RaulBlancoGonzalez/ManoBionica/ESQ/Esquema diseño interruptor y circuito en Placa.png

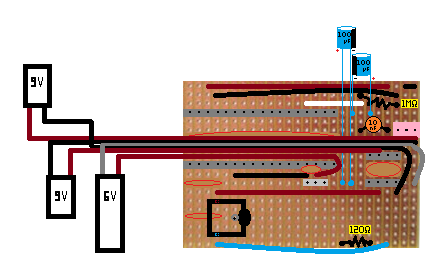
ESQ/Esquema diseño interruptor y circuito en Placa.png
