RaulBlancoGonzalez/ManoBionica/IMG/Robot50%.jpg

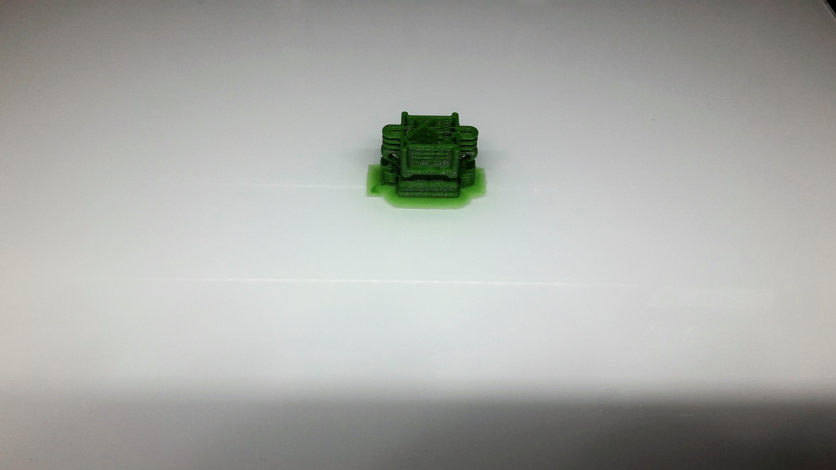
IMG/Robot50%.jpg
