RaulBlancoGonzalez/ManoBionica/ESQ/Arduino Micro.jpg

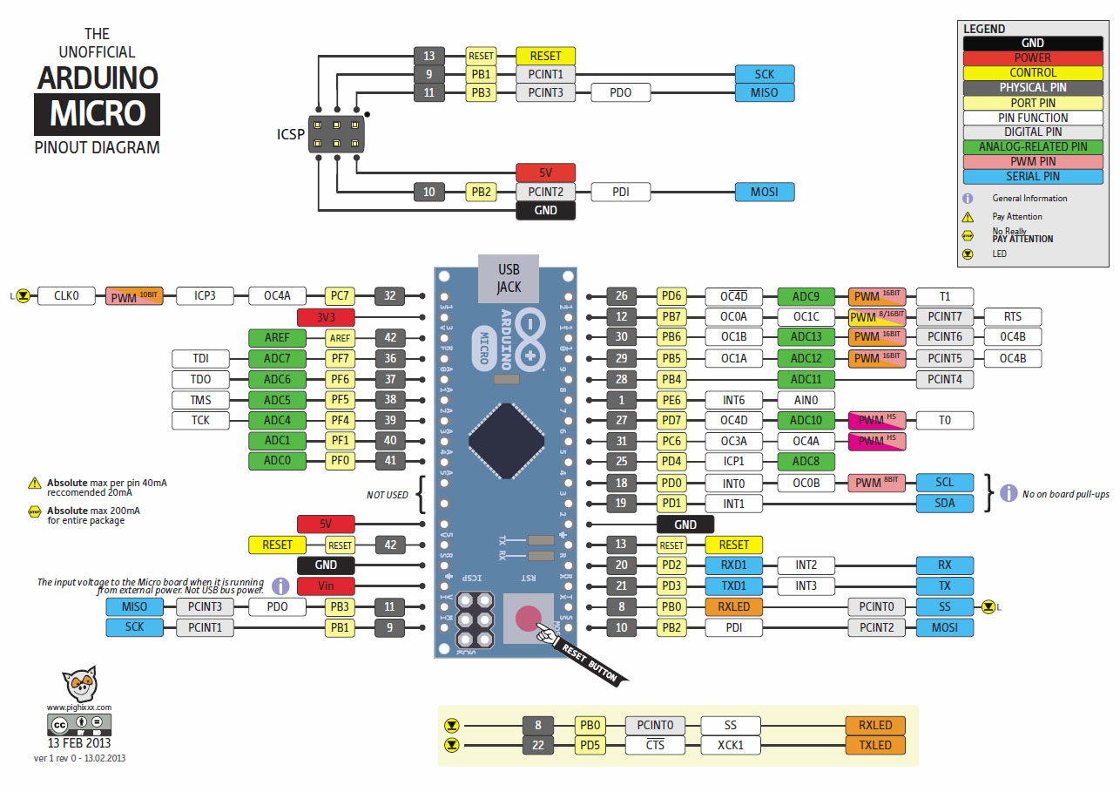
ESQ/Arduino Micro.jpg
