RaulBlancoGonzalez/ManoBionica/ESQ/ArduinoMicro_Pinout.png

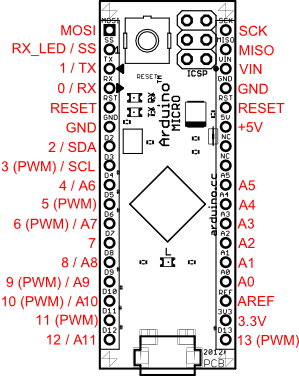
ESQ/ArduinoMicro_Pinout.png
