RaulBlancoGonzalez/ManoBionica/ESQ/Esquema Circuito Frontal.jpg

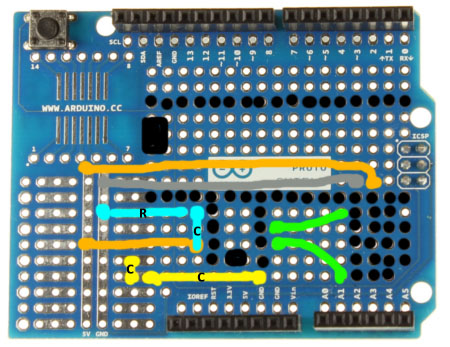
ESQ/Esquema Circuito Frontal.jpg
