RaulBlancoGonzalez/ManoBionica/ESQ/Esquema Circuito Trasero.jpg

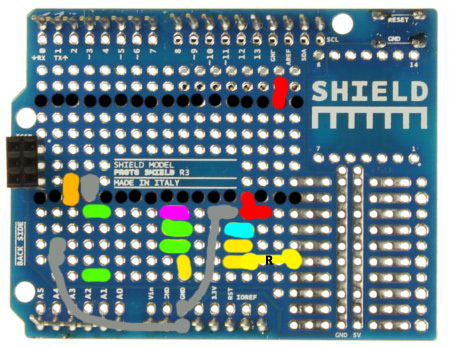
ESQ/Esquema Circuito Trasero.jpg
