RaulBlancoGonzalez/ManoBionica/IMG/Dedo1.jpg

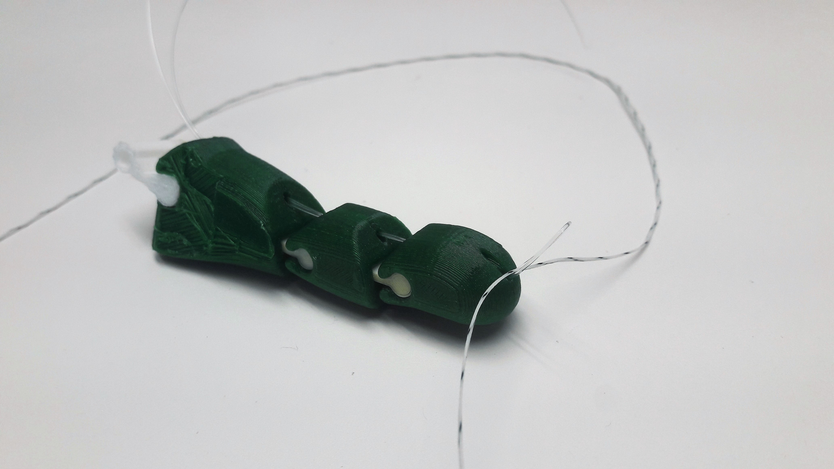
IMG/Dedo1.jpg
