RaulBlancoGonzalez/ManoBionica/IMG/Dedo3.jpg

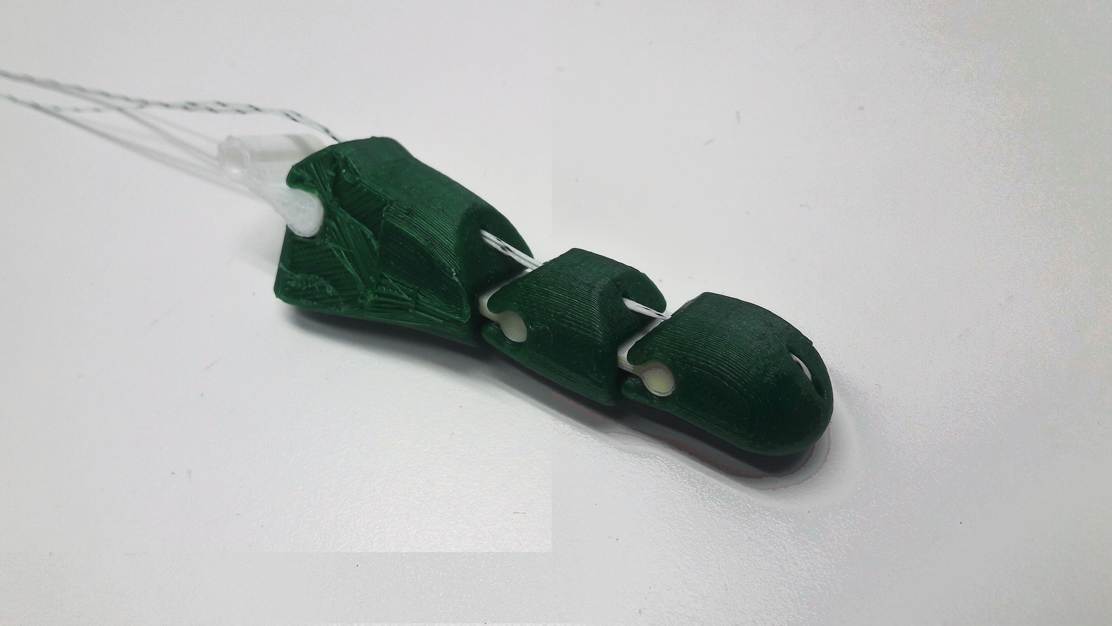
IMG/Dedo3.jpg
