RaulBlancoGonzalez/ManoBionica/IMG/ManoAbierta.jpg

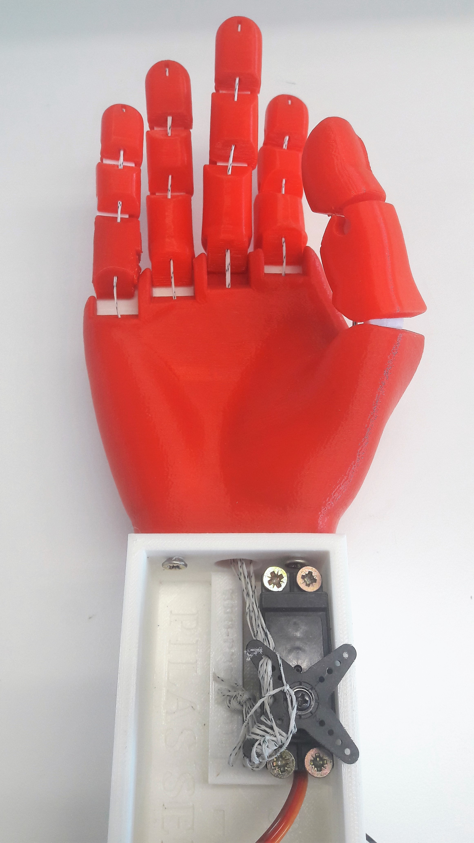
IMG/ManoAbierta.jpg
