RaulBlancoGonzalez/ManoBionica/IMG/Palmaydedos02.jpg

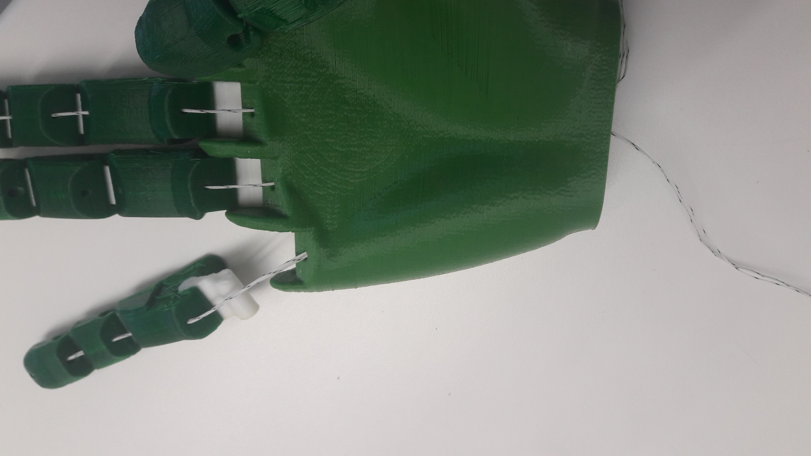
IMG/Palmaydedos02.jpg
