RaulBlancoGonzalez/ManoBionica/IMG/PlacaArduinoProtoShield.jpg

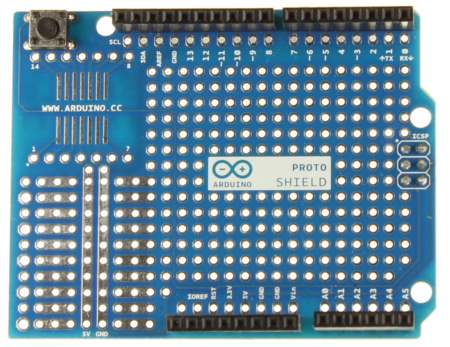
IMG/PlacaArduinoProtoShield.jpg
