RaulBlancoGonzalez/ManoBionica/IMG/PlacaBasePrototipado.jpg

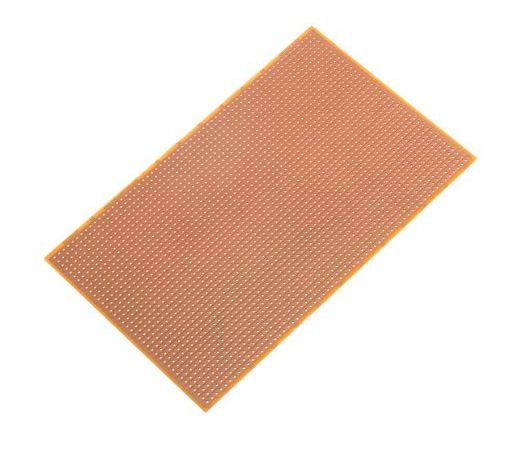
IMG/PlacaBasePrototipado.jpg
