RaulBlancoGonzalez/ManoBionica/IMG/Robot1%.jpg

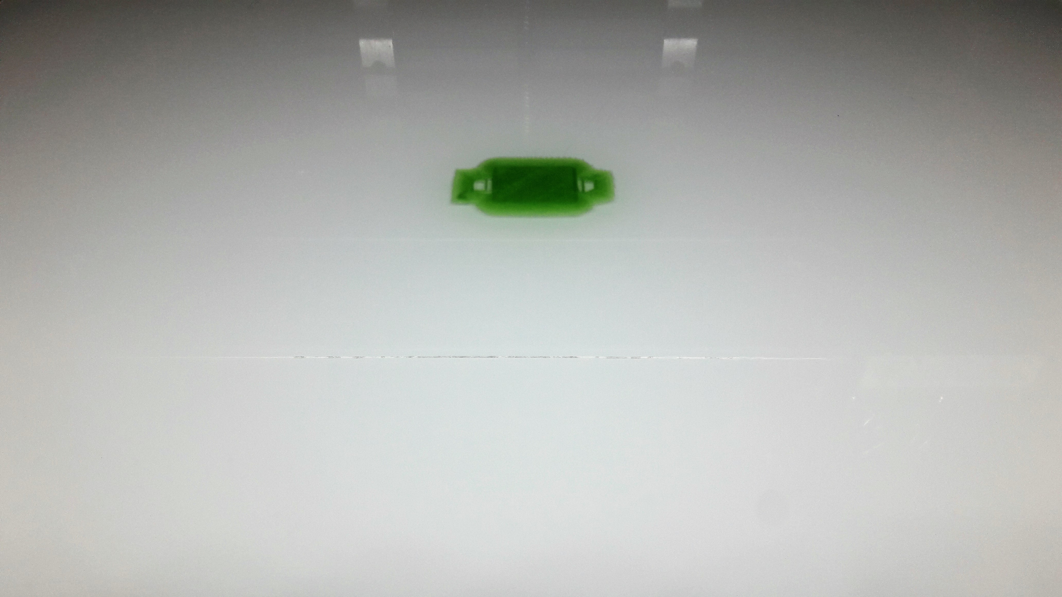
IMG/Robot1%.jpg
