RaulBlancoGonzalez/ManoBionica/IMG/Robot100%.jpg

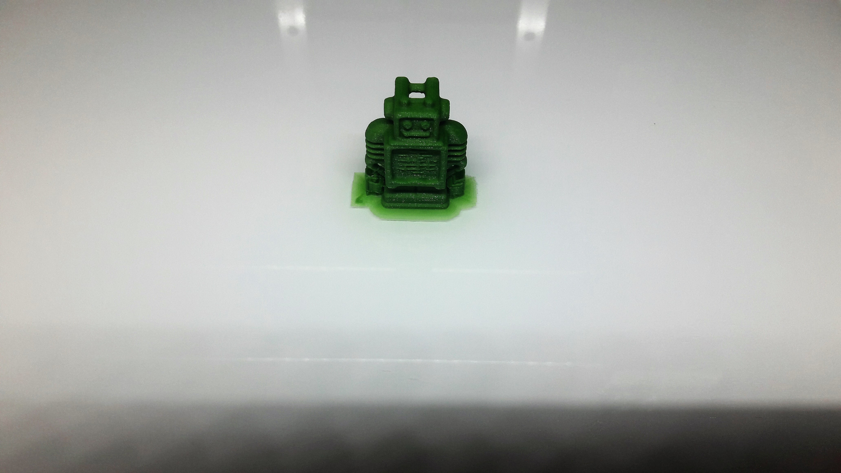
IMG/Robot100%.jpg
