RaulBlancoGonzalez/ManoBionica/IMG/Robot.jpg

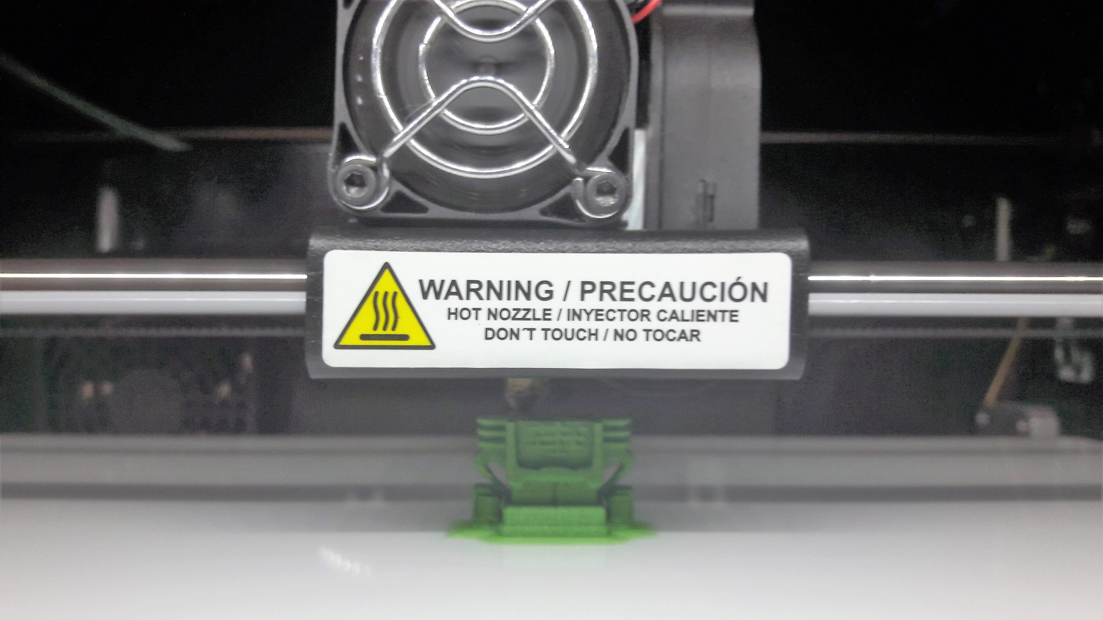
IMG/Robot.jpg
