RaulBlancoGonzalez/ManoBionica/IMG/SistemaCompleto.jpg

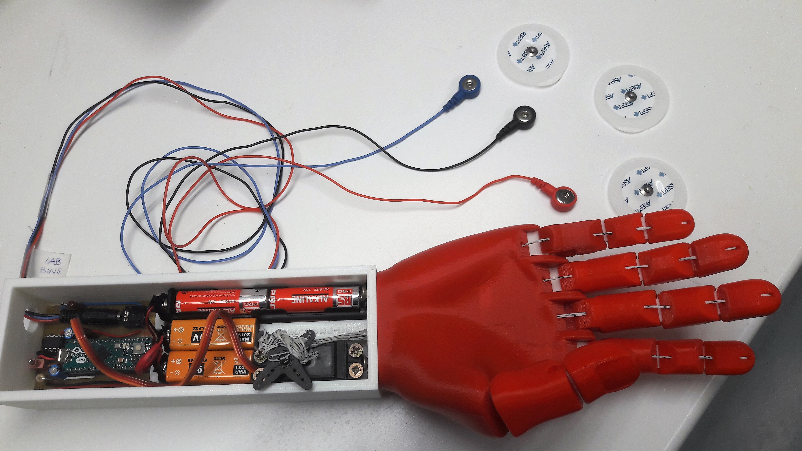
IMG/SistemaCompleto.jpg
