RaulBlancoGonzalez/ManoBionica/3D/STL/DedosIzquierda.stl

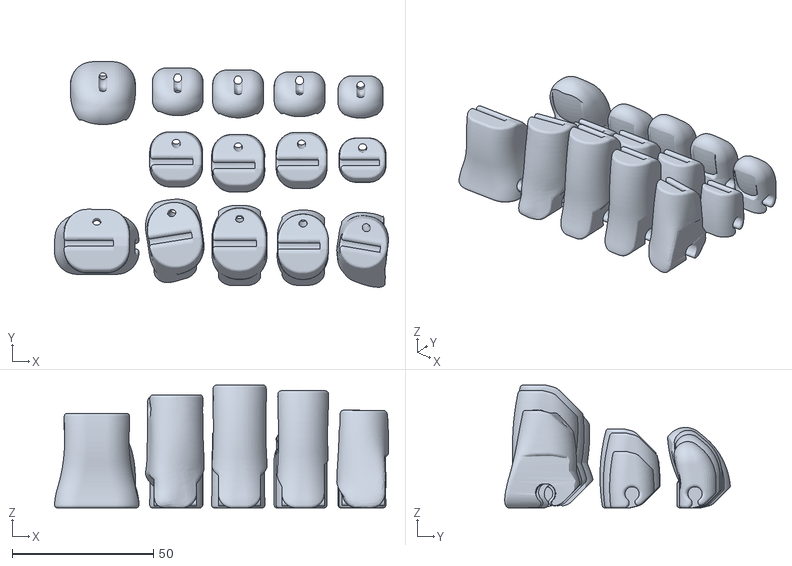
[picture p35: CAD file, 2018-05-22]
3D/STL/DedosIzquierda.stl
118.3 x 79.9 x 43.5
