RaulBlancoGonzalez/ManoBionica/3D/STL/ArticulacionPequeña.stl

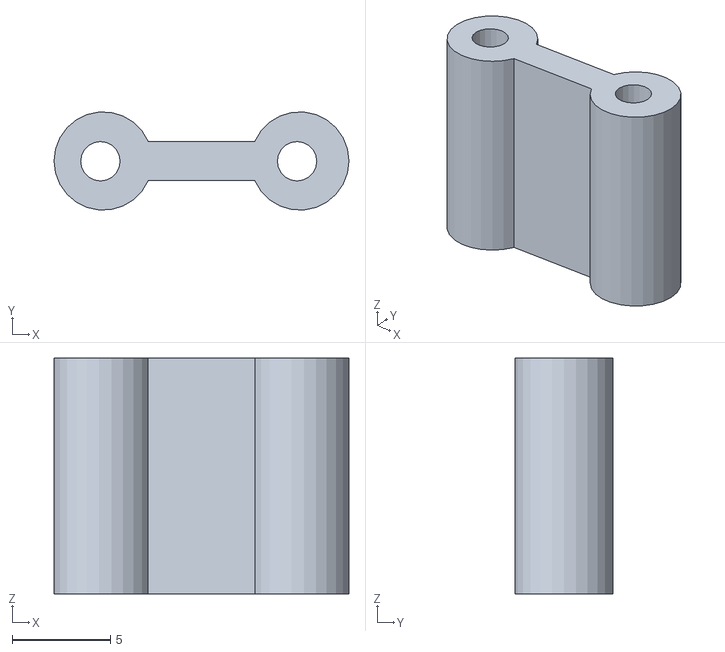
[picture p36: CAD file, 2018-05-22]
3D/STL/ArticulacionPequeña.stl
15.0 x 4.98 x 12.0
