RaulBlancoGonzalez/ManoBionica/3D/STL/Antebrazo.stl

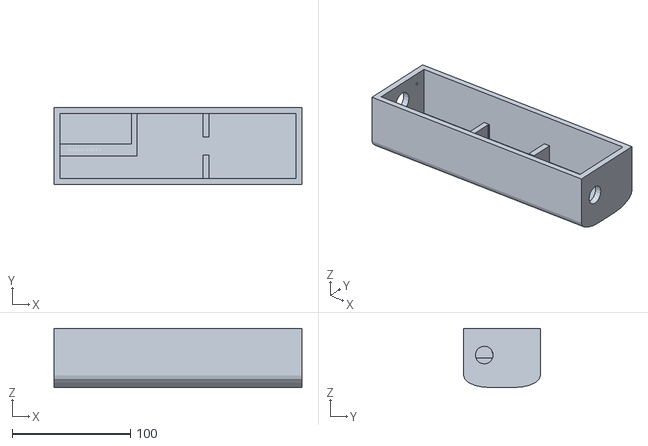
[picture p37: CAD file, 2018-05-22]
3D/STL/Antebrazo.stl
210.0 x 65.0 x 50.0
