RaulBlancoGonzalez/ManoBionica/3D/STL/PalmaDerecha.stl

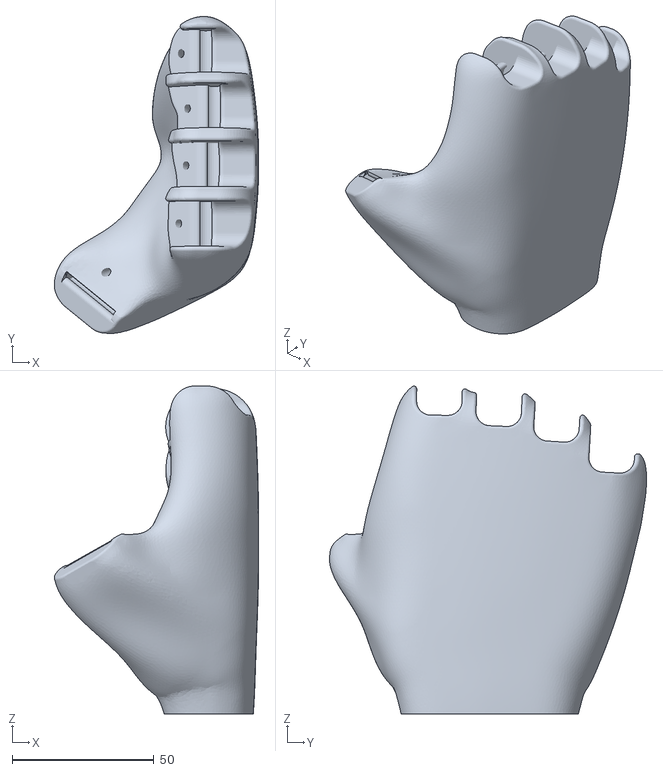
[picture p38: CAD file, 2018-05-22]
3D/STL/PalmaDerecha.stl
72.1 x 111.7 x 115.6
