RaulBlancoGonzalez/ManoBionica/3D/STL/ArticulacionGrande.stl

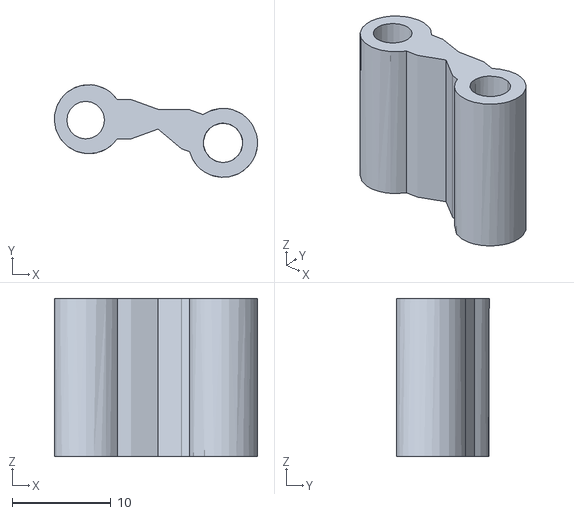
[picture p39: CAD file, 2018-05-22]
3D/STL/ArticulacionGrande.stl
20.5 x 9.37 x 16.0
