RaulBlancoGonzalez/ManoBionica/(list of files, cad)

Other CAD files:
3D/STL/DedosDerecha.stl
3D/STL/PalmaIzquierda.stl
