RaulBlancoGonzalez/ManoBionica/ESQ/Montaje Mano.pdf

EXPLODED VIEW; PROXIMAL AND DISTAL INTERPHALANGEAL

BILL OF MATERIALS

ITEM NUMBER | DESCRIPTION | NUMBER OFF

1-1 | THUMB PROXIMAL PHALANX | 1
1-2 | THUMB DISTAL PHALANX | 1
2-1 | INDEX PROXIMAL PHALANX | 1
2-2 | INDEX MIDDLE PHALANX | 1
2-3 | INDEX DISTAL PHALANX | 1
3-1 | LONG PROXIMAL PHALANX | 1
3-2 | LONG MIDDLE PHALANX | 1
3-3 | LONG DISTAL PHALANX | 1
4-1 | RING PROXIMAL PHALANX | 1
4-2 | RING MIDDLE PHALANX | 1
4-3 | RING DISTAL PHALANX | 1
5-1 | SMALL PROXIMAL PHALANX | 1
5-2 | SMALL MIDDLE PHALANX | 1
5-3 | SMALL DISTAL PHALANX | 1
6 | HAND BODY | 1
7 | PALMAR DIGITAL | 4
